jlmyra/PS3--JEEP-LANDY-BUGGY/JEEP-LANDY_Wiring_Diagram.png

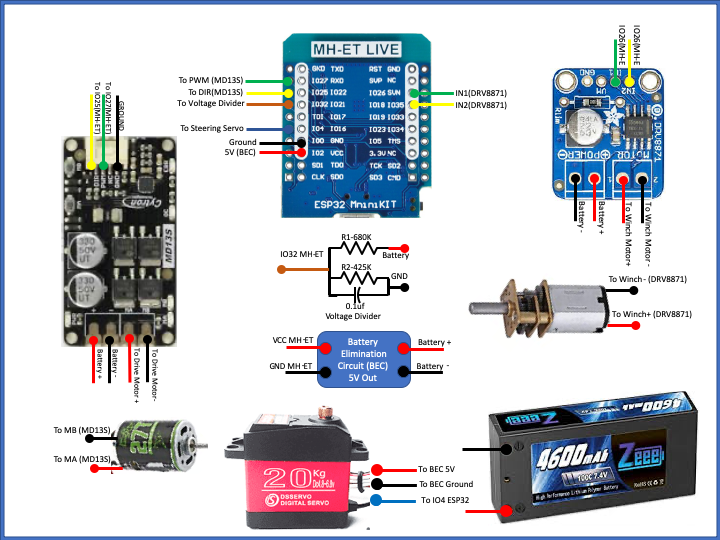
JEEP-LANDY_Wiring_Diagram.png
