jlmyra/PS3--JEEP-LANDY-BUGGY/JEEP_LANDY_BUGGY_PS3_ESP32-w_BAT_Model_Specific/Model_Variables.h

//***JEEP Variables***

//Steering Variables:
#define MV_servoMin 1100;
#define MV_servoMax 2075;

//Voltage Divider Resistors:
#define MV_R1 101600; //Voltage divider R1
#define MV_R2 41600; //Voltage Divider R2

//attery Voltage Correction Factor
#define MV_batCorrFactor 0.0;


//***LANDY Variables***
/*
//Steering Variables:
#define MV_servoMin 1125;
#define MV_servoMax 1925;

//Voltage Divider Resistors:
#define MV_R1 102800; //Voltage divider R1
#define MV_R2 41700; //Voltage Divider R2

//Battery Voltage Correction Factor
#define MV_batCorrFactor 0.0;
*/

//***BUGGY Variables***
/*
//Voltage Divider Resistors:
#define MV_R1 101600; //Voltage divider R1
#define MV_R2 41600; //Voltage Divider R2

//Steering Variables:
#define MV_servoMin 1225;
#define MV_servoMax 2025;

//Battery Voltage Correction Factor
#define MV_batCorrFactor 0.00;

*/
