jlmyra/PS3--JEEP-LANDY-BUGGY/JEEP_LANDY_BUGGY_PS3_ESP32-w_BAT_Model_Specific/Connection.ino

//*******************Check controller Connection********************************
 
void onConnection() {
   
  if (Ps3.isConnected()) 
  {
  Serial.println();
  Serial.println();
  Serial.println("********************************");
  Serial.println("*** PS3 Controller Connected ***");
  Serial.println("********************************");
  Serial.println();
  Serial.println();
  }
 }

//*******************END Check controller Connection********************************
